kelvinos2624/Anti-Back-Slouch-Reminder/(commit log)

2023-11-22 Created functions to retrieve accelerations
    Gets the accelerations in 3 ways, one raw, one converting the raws, and one using sensors_t_event
2023-11-22 Revert "Implemented math to get angle from acceleration"
    This reverts commit 736386b759e00b2837ea8e2cd652d57397fd4fef.
    [angle_math.cpp, angle_math.h]
2023-11-22 Revert "Created functions to retrieve accelerations"
    This reverts commit bba66965f00211cad97348f7aac49fde80d5a1f8.
    [sensors.cpp, sensors.h]
2023-11-22 Created functions to retrieve accelerations
    Gets the accelerations in 3 ways, one raw, one converting the raws, and one using Adafruit's sensors_t_event
2023-11-22 Added Electrical Schematic Revision Log via Upload
    Documented changes in the electrical schematic. This document details the initial planned schematic, followed by two revisions made up until our final version.
2023-11-22 Added flex sensor, buzzer, and led code
    [back_sensor_arduino.ino]
2023-11-22 Added code to output stats, angle, and flex to LCD
    Used LiquidCrystal_I2C library
    [back_sensor_arduino.ino]
